brunolalb/bathroom_fan/pcb/datasheets/HC-SR501 - PIR.png

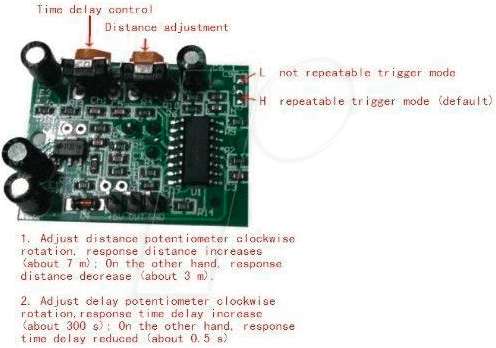
pcb/datasheets/HC-SR501 - PIR.png
