brunolalb/bathroom_fan/pcb/BathroomFan/BathroomFan.kicad_pcb

## KiCad design pcb/BathroomFan/BathroomFan.kicad_pcb (2026-08-18)

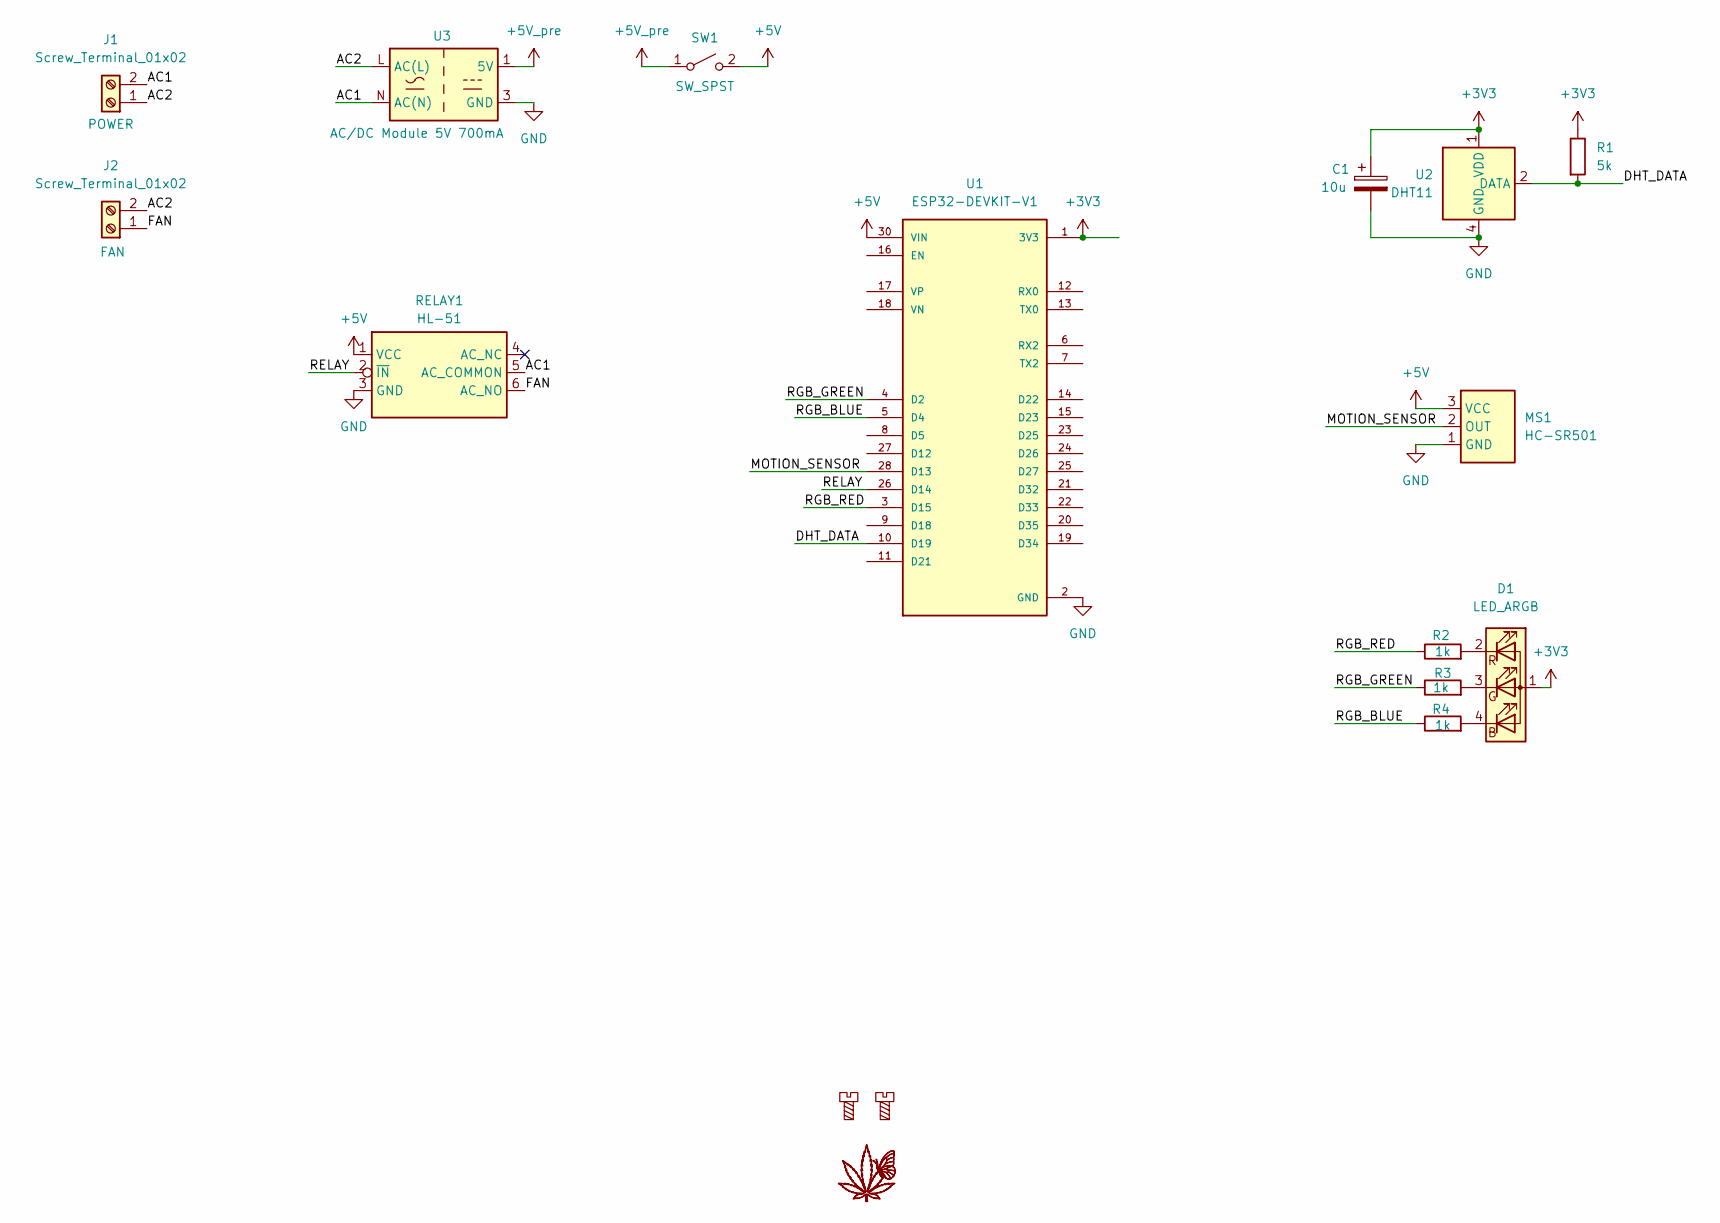
[picture p2: schematic BathroomFan.kicad_sch, Bathroom Fan Controller]

Parts:
C1: 10u; CP_Radial_D4.0mm_P2.00mm
D1: LED_ARGB; PinHeader_1x04_P2.54mm_Vertical
G1: LOGO
H1, H2: MountingScrew; MountingHole_4.3mm_M4
J1, J2: Screw_Terminal_01x02; TerminalBlock_Phoenix_MKDS-1,5-2-5.08_1x02_P5.08mm_Horizont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
MS1: HC-SR501; PinHeader_1x03_P2.54mm_Vertical
R1: 5k; R_0805_2012Metric_Pad1.20x1.40mm_HandSolder
R2, R3, R4: 1k; R_0805_2012Metric_Pad1.20x1.40mm_HandSolder
RELAY1: HL-51
SW1: SW_SPST; PinHeader_1x02_P2.54mm_Vertical
U1: ESP32-DEVKIT-V1; ESP32_DEVKIT_V1
U2: DHT11; PinHeader_1x04_P2.54mm_Vertical
U3: AC/DC Module 5V 700mA; ACDC_Module_5V_700mA

Connections:
+3V3: C1.1, D1.1 (A), R1.1, U1.1 (3V3), U2.1 (VDD)
+5V: MS1.3 (VCC), RELAY1.1 (VCC), SW1.2 (B), U1.30 (VIN)
+5V_pre: SW1.1 (A), U3.1 (5V)
/AC1: J1.2, RELAY1.5 (AC_COMMON), U3.N (AC(N))
/AC2: J1.1, J2.2, U3.L (AC(L))
/DHT_DATA: R1.2, U1.10 (D19), U2.2 (DATA)
/FAN: J2.1, RELAY1.6 (AC_NO)
/MOTION_SENSOR: MS1.2 (OUT), U1.28 (D13)
/RELAY: RELAY1.2 (~IN), U1.26 (D14)
/RGB_BLUE: R4.1, U1.5 (D4)
/RGB_GREEN: R3.1, U1.4 (D2)
/RGB_RED: R2.1, U1.3 (D15)
GND: C1.2, MS1.1 (GND), RELAY1.3 (GND), U1.2 (GND), U1.29 (GND), U2.4 (GND), U3.3 (GND)
unnamed: D1.4 (BK), R4.2
unnamed: D1.3 (GK), R3.2
unnamed: D1.2 (RK), R2.2

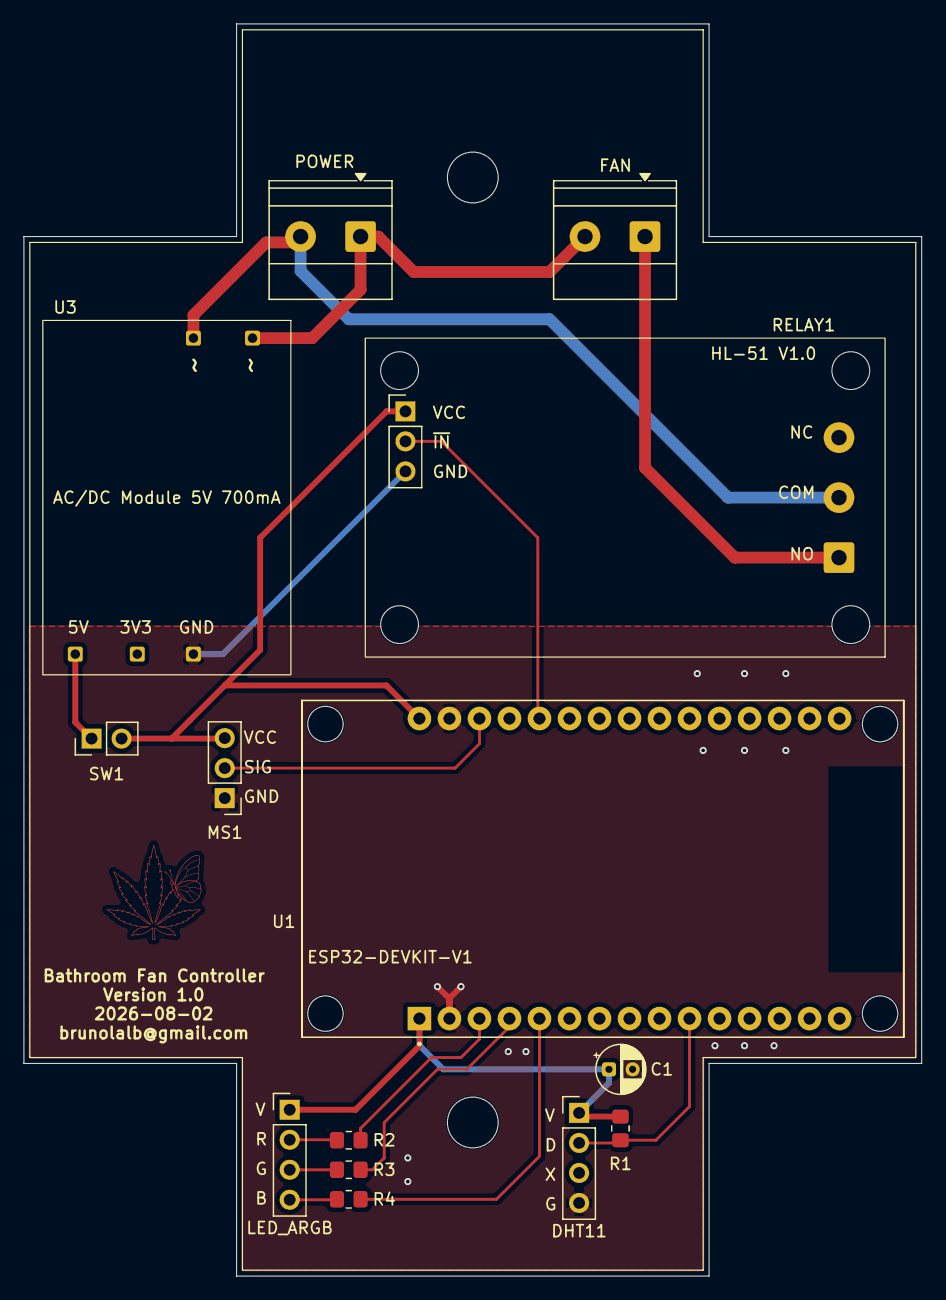
[picture p3: board BathroomFan.kicad_pcb from above]

Board: 2 copper layers, 76.0 x 106.0 mm, 17 parts (0 on the bottom side), 16 nets.
