brunolalb/bathroom_fan/(commit log)

2026-06-29 moved led functionality to own lib
2026-06-29 moved humidity and temperature sensor to own library
2026-06-29 moved movement sensor (PIR) to own library
2026-06-29 moved switch functionality to own lib
2026-06-29 removed the ota timer, since the elegantota can be initialized only once
2026-06-29 added a config page to the index, you can config humidity limits, quiet times, how long the fan stays on upon motion detection
2026-06-29 reset settings and clear wifi credentials were not working properly. also made the wifimanager portal non blocking and optimized the wifi monitoring task
    [HardwareConfig.h, main.cpp]
2026-06-29 control loop was not getting data from the DHT (queue not initialized) and made the movement sensor logic ignore the time if the time is not set
2026-07-01 added a dashboard to the initial page. contains current time, fan status, humidity and temperature gauges
2026-07-01 rotate the spiral and show wind when the fan is on; fixed spiral and hidden wind icons when fan is off
2026-07-02 moved the arduino code to specific folder
2026-07-02 SCH: initial schematic (still missing some stuff...)
    [BathroomFan.kicad_pcb, BathroomFan.kicad_sch]
2026-07-03 SCH - added ac/dc module with switch, relay and connectors for power and fan
    [BathroomFan.kicad_sch]
2026-07-05 improved relay footprint with actual part, added munting holes for screws
    [BathroomFan.kicad_sch]
2026-07-05 PCB: initial Board format and component placement
    [BathroomFan.kicad_pcb, BathroomFan.kicad_sch]
2026-07-05 SCH and PCB: redistributed ESP32 pins for better layout, first version of layout finished
    [BathroomFan.kicad_pcb, BathroomFan.kicad_sch]
2026-08-02 SCH and PCB: added logo, adjusted silk identifier
    [BathroomFan.kicad_pcb, BathroomFan.kicad_sch]
2026-08-02 Release Version 1.0
    [BathroomFan.kicad_pcb]
2026-08-18 fixed BOM
    [BathroomFan - Version 1.0.csv, BathroomFan - Version 1.0.ods]
